davidlesman/EE-Design-Project/(commit log)

2025-05-15 no delays, IR freq wrong
    [EEDesignProject.ino]
2025-05-19 start IR sensor
2025-05-22 current attempt at radio detection
2025-06-09 final arduino, interface subject to change
2025-06-11 magnet report
